DanielHeEGG/eve-flight-computer/eve-flight-computer.kicad_pcb

## KiCad design eve-flight-computer.kicad_pcb (2024-09-11)

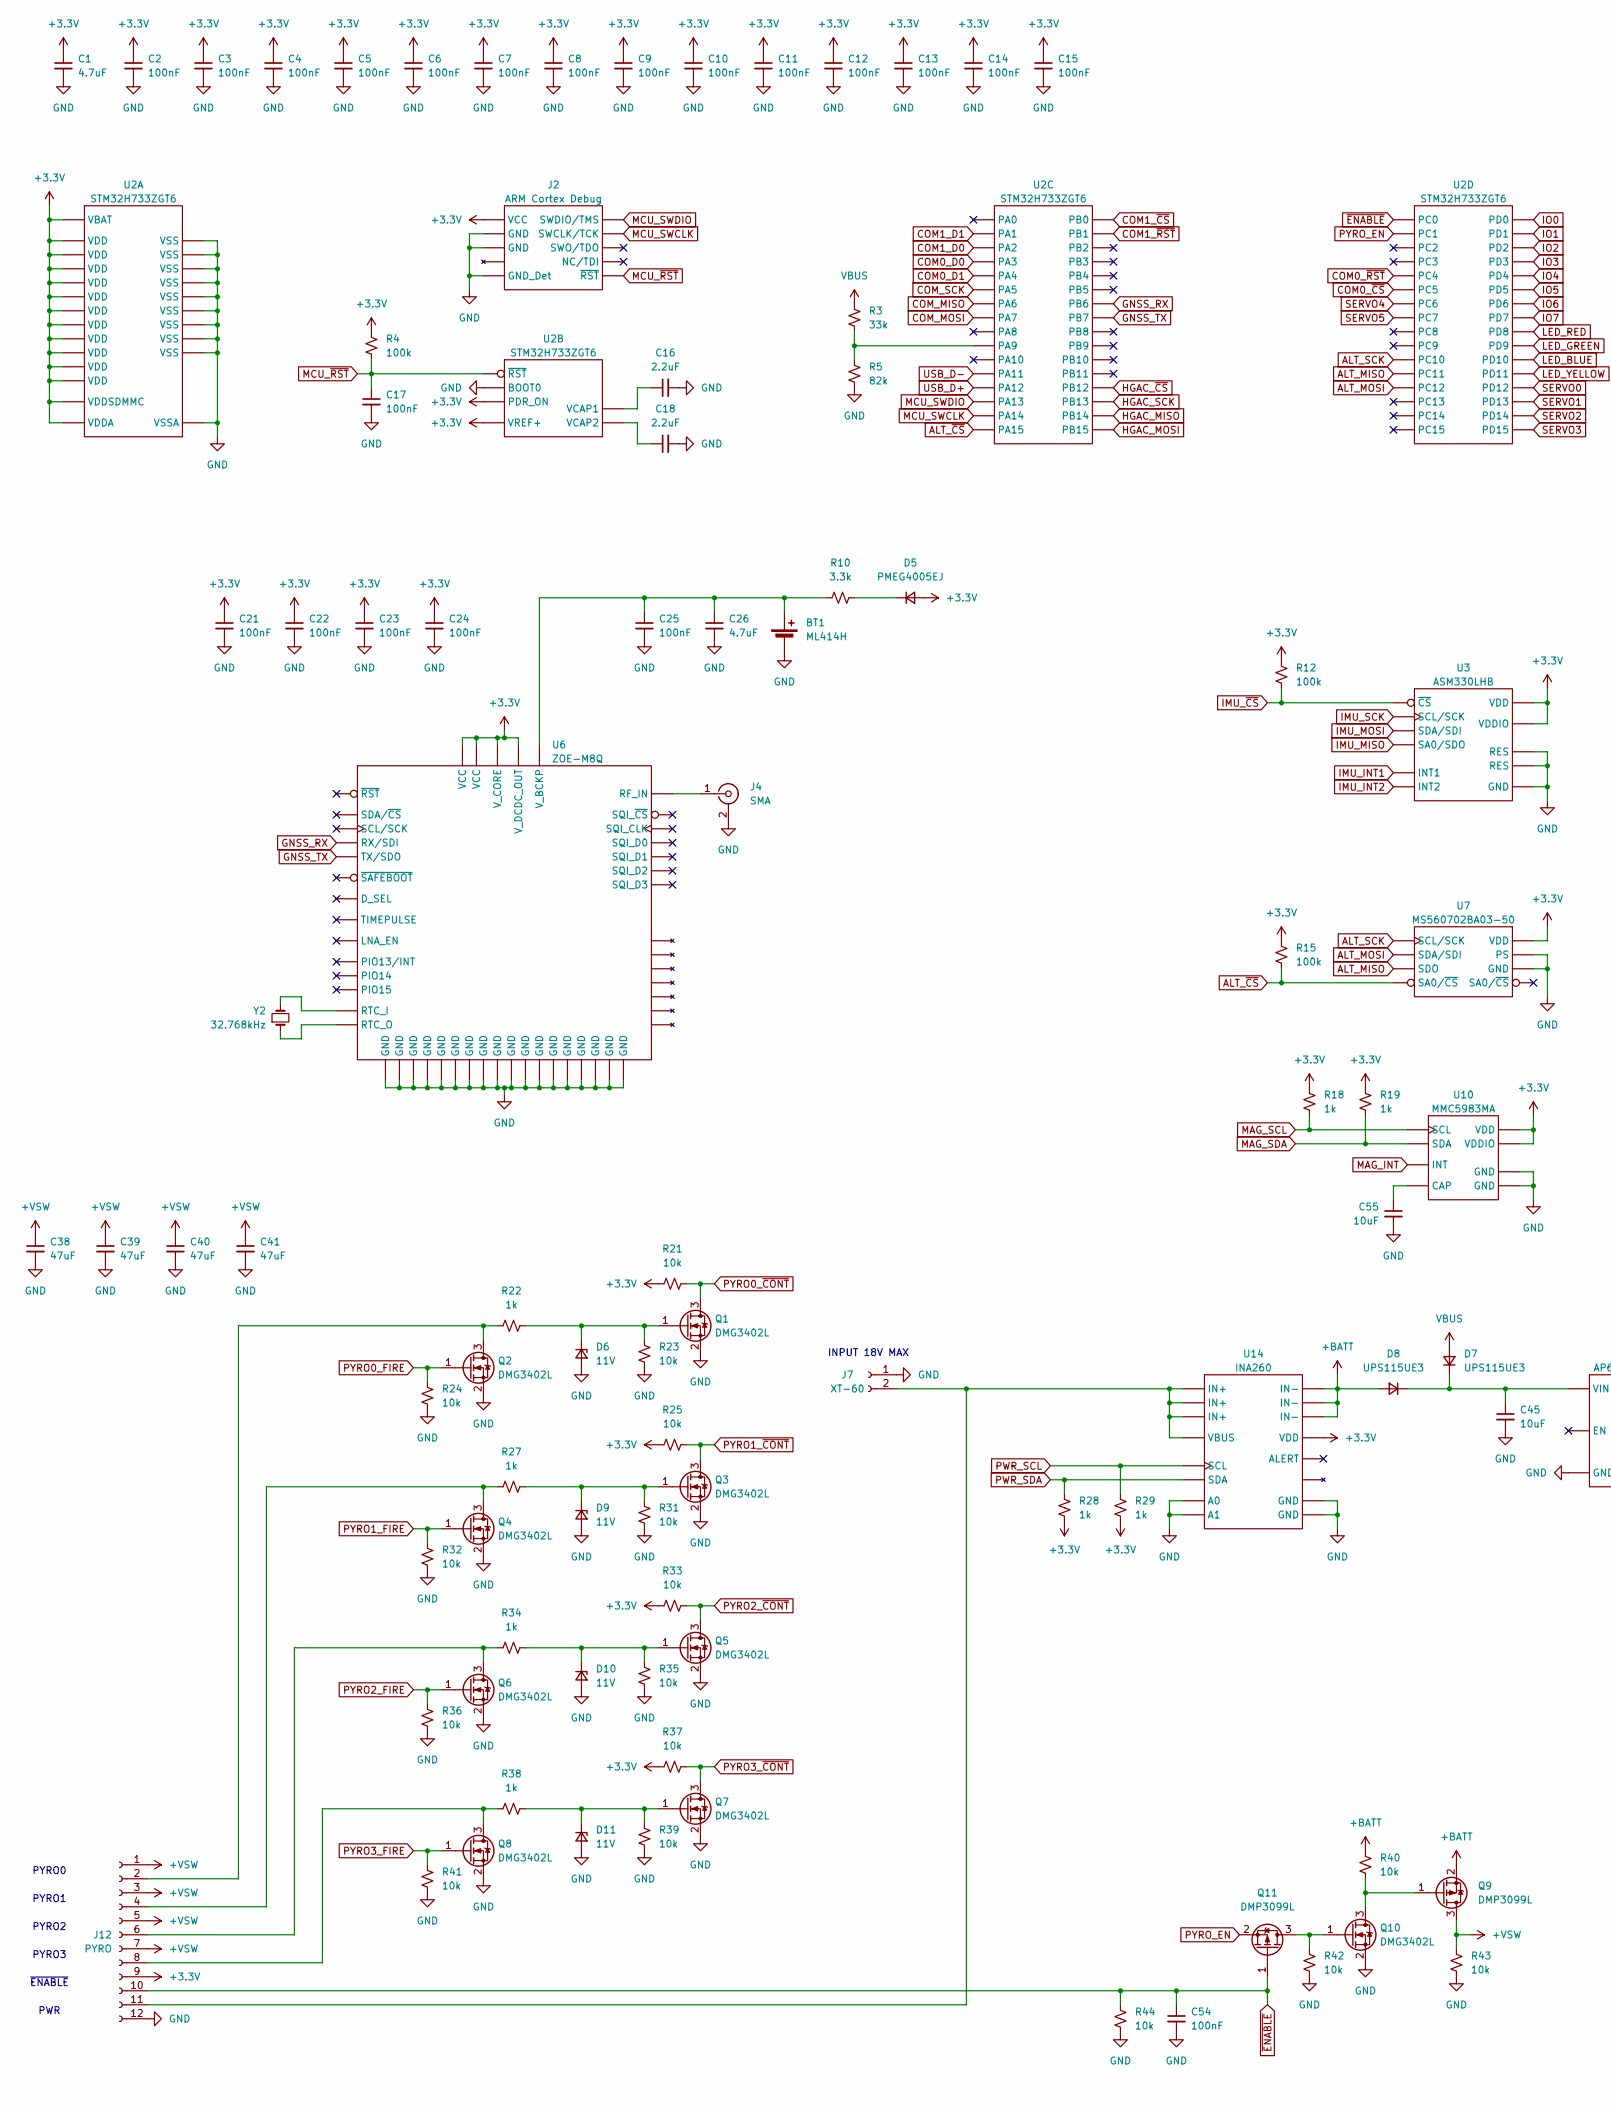
[picture p1: schematic eve-flight-computer.kicad_sch, part in row 1, column 1]

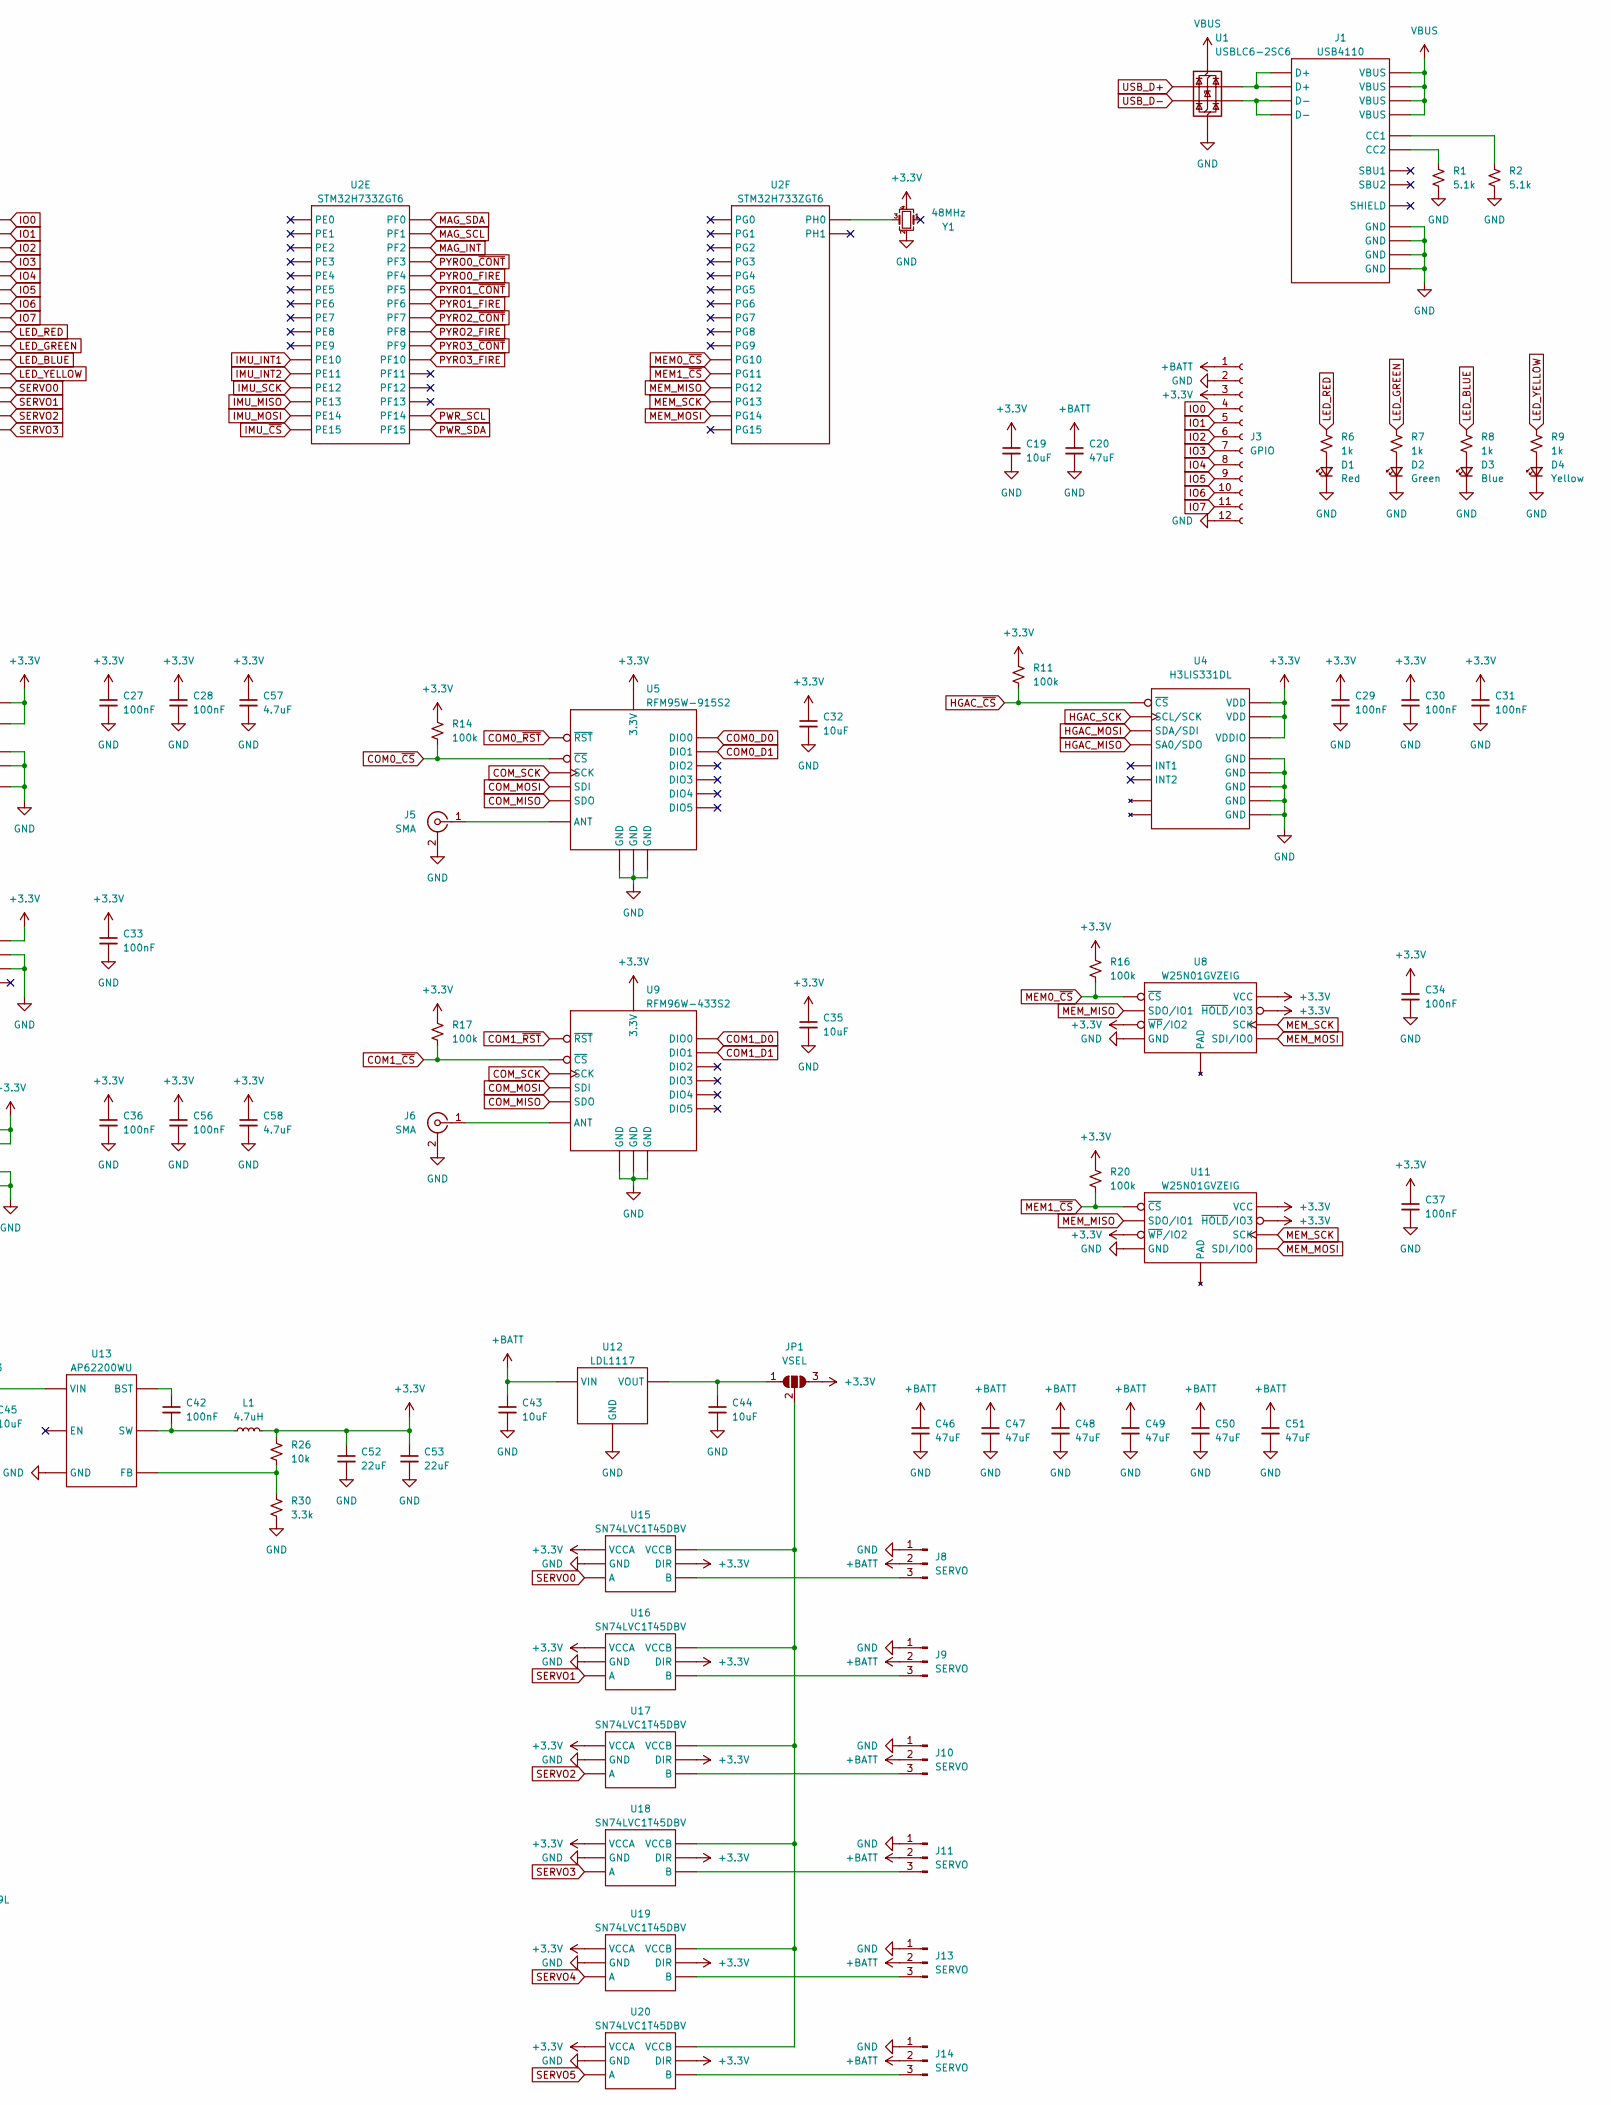
[picture p2: schematic eve-flight-computer.kicad_sch, part in row 1, column 2]

Parts:
BT1: ML414H; Part # ML414H-IV01E
C1, C26, C57, C58: 4.7uF; 0402_1005M; Part # Generic 4.7uF 6.3V X5R 0402 MLCC
C2, C3, C4, C5, C6, C7, C8, C9, C10, C11, C12, C13, C14, C15, C17, C21, C22, C23, C24, C25, C27, C28, C29, C30, C31, C33, C34, C36, C37, C42, C54, C56: 100nF; 0402_1005M; Part # Generic 100nF 25V X7R 0402 MLCC
C16, C18: 2.2uF; 0402_1005M; Part # Generic 2.2uF 6.3V X5R 0402 MLCC
C19, C32, C35, C43, C44, C45, C55: 10uF; 0805_2012M; Part # Generic 10uF 25V X5R 0805 MLCC
C20, C38, C39, C40, C41, C46, C47, C48, C49, C50, C51: 47uF; C_1206_3216Metric; Part # Generic 47uF 25V X5R 1206 MLCC
C52, C53: 22uF; 0805_2012M; Part # Generic 22uF 6.3V X5R 0805 MLCC
D1: Red; D_0603_1608Metric; Part # Generic Red 0603 LED
D2: Green; D_0603_1608Metric; Part # Generic Green 0603 LED
D3: Blue; D_0603_1608Metric; Part # Generic Blue 0603 LED
D4: Yellow; D_0603_1608Metric; Part # Generic Yellow 0603 LED
D5: PMEG4005EJ; D_SOD-323; Part # PMEG4005EJ
D6, D9, D10, D11: 11V; D_SOD-123; Part # MMSZ11T1G
D7, D8: UPS115UE3; D_Powermite_AK; Part # UPS115UE3/TR7
J1: USB4110; USB_C_Receptacle_GCT_USB4110; Part # USB4110-GF-A
J2: ARM Cortex Debug; PinHeader_2x05_P1.27mm_Vertical_SMD; Part # 20021121-00010C4LF
J3: GPIO; PinSocket_1x12_P2.54mm_Vertical; Part # 1-282834-2
J4, J5, J6: SMA; SMA_Amphenol_132289_EdgeMount; Part # 132289
J7: XT-60; XT60PW-M; Part # XT60PW-M
J8, J9, J10, J11, J13, J14: SERVO; JST_XH_B3B-XH-A_1x03_P2.50mm_Vertical; Part # B3B-XH-A
J12: PYRO; PinSocket_1x12_P2.54mm_Vertical; Part # 1-282834-2
JP1: VSEL; SolderJumper-3_P1.3mm_Open_Pad1.0x1.5mm
L1: 4.7uH; L_1210_3225Metric; Part # DFE322520FD-4R7M
Q1, Q2, Q3, Q4, Q5, Q6, Q7, Q8, Q10: DMG3402L; SOT-23-3; Part # DMG3402L-7
Q9, Q11: DMP3099L; SOT-23-3; Part # DMP3099L-7
R1, R2: 5.1k; 0402_1005M; Part # Generic 5.1k 1% 0402 Chip Resistor
R3: 33k; 0402_1005M; Part # Generic 33k 1% 0402 Chip Resistor
R4, R11, R12, R14, R15, R16, R17, R20: 100k; 0402_1005M; Part # Generic 100k 1% 0402 Chip Resistor
R5: 82k; 0402_1005M; Part # Generic 82k 1% 0402 Chip Resistor
R6, R7, R8, R9, R18, R19, R22, R27, R28, R29, R34, R38: 1k; 0402_1005M; Part # Generic 1k 1% 0402 Chip Resistor
R10, R30: 3.3k; 0402_1005M; Part # Generic 3.3k 1% 0402 Chip Resistor
R21, R23, R24, R25, R26, R31, R32, R33, R35, R36, R37, R39, R40, R41, R42, R43, R44: 10k; 0402_1005M; Part # Generic 10k 1% 0402 Chip Resistor
U1: USBLC6-2SC6; SOT-23-6; Part # USBLC6-2SC6
U2: STM32H733ZGT6; LQFP-144_20x20mm_P0.5mm; Part # STM32H733ZGT6
U3: ASM330LHB; LGA-14_3x2.5mm_P0.5mm_LayoutBorder3x4y; Part # ASM330LHBTR
U4: H3LIS331DL; LGA-16_3x3mm_P0.5mm_LayoutBorder3x5y; Part # H3LIS331DLTR
U5: RFM95W-915S2; RFM9xW-xxxS2; Part # RFM95W-915S2
U6: ZOE-M8Q; Part # ZOE-M8Q-0
U7: MS560702BA03-50; MS5607-02BA; Part # MS560702BA03-50
U8, U11: W25N01GVZEIG; WSON-8-1EP_8x6mm_P1.27mm_EP3.4x4.3mm; Part # W25N01GVZEIG
U9: RFM96W-433S2; RFM9xW-xxxS2; Part # RFM96W-433S2
U10: MMC5983MA; LGA-16_3x3mm_P0.5mm; Part # MMC5983MA
U12: LDL1117; SOT-223-3_TabPin2; Part # LDL1117S50R
U13: AP62200WU; SOT-23-6; Part # AP62200WU-7
U14: INA260; TSSOP-16_4.4x5mm_P0.65mm; Part # INA260AIPWR
U15, U16, U17, U18, U19, U20: SN74LVC1T45DBV; SOT-23-6; Part # SN74LVC1T45DBV
Y1: 48MHz; Crystal_SMD_2520-4Pin_2.5x2.0mm; Part # ECS-2520MV-480-CN-TR
Y2: 32.768kHz; Crystal_SMD_MicroCrystal_CM9V-T1A-2Pin_1.6x1.0mm; Part # CM9V-T1A-32.768KHZ-7PF-100PPM-TA-QC

Connections:
+3.3V: C1.1, C2.1, C3.1, C4.1, C5.1, C6.1, C7.1, C8.1, C9.1, C10.1, C11.1, C12.1, C13.1, C14.1, C15.1, C19.1, C21.1, C22.1, C23.1, C24.1, C27.1, C28.1, C29.1, C30.1, C31.1, C32.1, C33.1, C34.1, C35.1, C36.1, C37.1, C52.1, C53.1, C56.1, C57.1, C58.1, D5.2 (A), J2.1 (VCC), J3.3, J12.9, JP1.3 (B), L1.2, R4.1, R11.1, R12.1, R14.1, R15.1, R16.1, R17.1, R18.1, R19.1, R20.1, R21.1, R25.1, R26.1, R28.2, R29.2, R33.1, R37.1, U2.6 (VBAT), U2.17 (VDD), U2.30 (VDD), U2.32 (VREF+), U2.33 (VDDA), U2.39 (VDD), U2.52 (VDD), U2.62 (VDD), U2.72 (VDD), U2.84 (VDD), U2.95 (VDD), U2.108 (VDD), U2.121 (VDDSDMMC), U2.131 (VDD), U2.143 (PDR_ON), U2.144 (VDD), U3.5 (VDDIO), U3.8 (VDD), U4.1 (VDDIO), U4.14 (VDD), U4.15 (VDD), U5.13 (3.3V), U6.G1 (V_CORE), U6.H1 (V_DCDC_OUT), U6.J1 (VCC), U6.J2 (VCC), U7.1 (VDD), U8.3 (~WP/IO2), U8.7 (~HOLD/IO3), U8.8 (VCC), U9.13 (3.3V), U10.2 (VDD), U10.13 (VDDIO), U11.3 (~WP/IO2), U11.7 (~HOLD/IO3), U11.8 (VCC), U14.10 (VDD), U15.1 (VCCA), U15.5 (DIR), U16.1 (VCCA), U16.5 (DIR), U17.1 (VCCA), U17.5 (DIR), U18.1 (VCCA), U18.5 (DIR), U19.1 (VCCA), U19.5 (DIR), U20.1 (VCCA), U20.5 (DIR), Y1.4
+BATT: C20.1, C43.1, C46.1, C47.1, C48.1, C49.1, C50.1, C51.1, D8.2 (A), J3.1, J8.2, J9.2, J10.2, J11.2, J13.2, J14.2, Q9.2 (S), R40.1, U12.3 (VIN), U14.14 (IN-), U14.15 (IN-), U14.16 (IN-)
+VSW: C38.1, C39.1, C40.1, C41.1, J12.1, J12.3, J12.5, J12.7, Q9.3 (D), R43.1
ALT_MISO: U2.112 (PC11), U7.6 (SDO)
ALT_MOSI: U2.113 (PC12), U7.7 (SDA/SDI)
ALT_SCK: U2.111 (PC10), U7.8 (SCL/SCK)
ALT_~CS: R15.2, U2.110 (PA15), U7.5 (SA0/~CS)
COM0_D0: U2.37 (PA3), U5.14 (DIO0)
COM0_D1: U2.40 (PA4), U5.15 (DIO1)
COM0_~CS: R14.2, U2.45 (PC5), U5.5 (~CS)
COM0_~RST: U2.44 (PC4), U5.6 (~RST)
COM1_D0: U2.36 (PA2), U9.14 (DIO0)
COM1_D1: U2.35 (PA1), U9.15 (DIO1)
COM1_~CS: R17.2, U2.46 (PB0), U9.5 (~CS)
COM1_~RST: U2.47 (PB1), U9.6 (~RST)
COM_MISO: U2.42 (PA6), U5.2 (SDO), U9.2 (SDO)
COM_MOSI: U2.43 (PA7), U5.3 (SDI), U9.3 (SDI)
COM_SCK: U2.41 (PA5), U5.4 (SCK), U9.4 (SCK)
GND: BT1.2 (-), C1.2, C2.2, C3.2, C4.2, C5.2, C6.2, C7.2, C8.2, C9.2, C10.2, C11.2, C12.2, C13.2, C14.2, C15.2, C16.2, C17.2, C18.2, C19.2, C20.2, C21.2, C22.2, C23.2, C24.2, C25.2, C26.2, C27.2, C28.2, C29.2, C30.2, C31.2, C32.2, C33.2, C34.2, C35.2, C36.2, C37.2, C38.2, C39.2, C40.2, C41.2, C43.2, C44.2, C45.2, C46.2, C47.2, C48.2, C49.2, C50.2, C51.2, C52.2, C53.2, C54.2, C55.2, C56.2, C57.2, C58.2, D1.1 (K), D2.1 (K), D3.1 (K), D4.1 (K), D6.2 (A), D9.2 (A), D10.2 (A), D11.2 (A), J1.A1 (GND), J1.A12 (GND), J1.B1 (GND), J1.B12 (GND), J2.3 (GND), J2.5 (GND), J2.9 (GND_Det), J3.2, J3.12, J4.2 (Ext), J5.2 (Ext), J6.2 (Ext), J7.1, J8.1, J9.1, J10.1, J11.1, J12.12, J13.1, J14.1, Q1.2 (S), Q2.2 (S), Q3.2 (S), Q4.2 (S), Q5.2 (S), Q6.2 (S), Q7.2 (S), Q8.2 (S), Q10.2 (S), R1.2, R2.2, R5.2, R23.2, R24.2, R30.2, R31.2, R32.2, R35.2, R36.2, R39.2, R41.2, R42.2, R43.2, R44.2, U1.2, U2.16 (VSS), U2.31 (VSSA), U2.38 (VSS), U2.51 (VSS), U2.61 (VSS), U2.83 (VSS), U2.94 (VSS), U2.107 (VSS), U2.120 (VSS), U2.130 (VSS), U2.138 (BOOT0), U3.2 (RES), U3.3 (RES), U3.7 (GND), U4.5 (GND), U4.10 (GND), U4.12 (GND), U4.13 (GND), U4.16 (GND), U5.1 (GND), U5.8 (GND), U5.10 (GND), U6.A1 (GND), U6.A3 (GND), U6.A5 (GND), U6.A7 (GND), U6.A8 (GND), U6.A9 (GND), U6.B9 (GND), U6.C7 (GND), U6.C9 (GND), U6.D6 (GND), U6.D9 (GND), U6.E7 (GND), U6.F7 (GND), U6.G3 (GND), U6.G6 (GND), U6.G7 (GND), U6.J3 (GND), U6.J9 (GND), U7.2 (PS), U7.3 (GND), U8.4 (GND), U9.1 (GND), U9.8 (GND), U9.10 (GND), U10.9 (GND), U10.11 (GND), U11.4 (GND), U12.1 (GND), U13.1 (GND), U14.4 (A1), U14.5 (A0), U14.6 (GND), U14.11 (GND), U15.2 (GND), U16.2 (GND), U17.2 (GND), U18.2 (GND), U19.2 (GND), U20.2 (GND), Y1.2
GNSS_RX: U2.136 (PB6), U6.J4 (RX/SDI)
GNSS_TX: U2.137 (PB7), U6.J5 (TX/SDO)
HGAC_MISO: U2.75 (PB14), U4.7 (SA0/SDO)
HGAC_MOSI: U2.76 (PB15), U4.6 (SDA/SDI)
HGAC_SCK: U2.74 (PB13), U4.4 (SCL/SCK)
HGAC_~CS: R11.2, U2.73 (PB12), U4.8 (~CS)
IMU_INT1: U2.63 (PE10), U3.4 (INT1)
IMU_INT2: U2.64 (PE11), U3.9 (INT2)
IMU_MISO: U2.66 (PE13), U3.1 (SA0/SDO)
IMU_MOSI: U2.67 (PE14), U3.14 (SDA/SDI)
IMU_SCK: U2.65 (PE12), U3.13 (SCL/SCK)
IMU_~CS: R12.2, U2.68 (PE15), U3.12 (~CS)
IO0: J3.4, U2.114 (PD0)
IO1: J3.5, U2.115 (PD1)
IO2: J3.6, U2.116 (PD2)
IO3: J3.7, U2.117 (PD3)
IO4: J3.8, U2.118 (PD4)
IO5: J3.9, U2.119 (PD5)
IO6: J3.10, U2.122 (PD6)
IO7: J3.11, U2.123 (PD7)
LED_BLUE: R8.1, U2.79 (PD10)
LED_GREEN: R7.1, U2.78 (PD9)
LED_RED: R6.1, U2.77 (PD8)
LED_YELLOW: R9.1, U2.80 (PD11)
MAG_INT: U2.12 (PF2), U10.15 (INT)
MAG_SCL: R18.2, U2.11 (PF1), U10.1 (SCL)
MAG_SDA: R19.2, U2.10 (PF0), U10.16 (SDA)
MCU_SWCLK: J2.4 (SWCLK/TCK), U2.109 (PA14)
MCU_SWDIO: J2.2 (SWDIO/TMS), U2.105 (PA13)
MCU_~RST: C17.1, J2.10 (~RST), R4.2, U2.25 (~RST)
MEM0_~CS: R16.2, U2.125 (PG10), U8.1 (~CS)
MEM1_~CS: R20.2, U2.126 (PG11), U11.1 (~CS)
MEM_MISO: U2.127 (PG12), U8.2 (SDO/IO1), U11.2 (SDO/IO1)
MEM_MOSI: U2.129 (PG14), U8.5 (SDI/IO0), U11.5 (SDI/IO0)
MEM_SCK: U2.128 (PG13), U8.6 (SCK), U11.6 (SCK)
unnamed: BT1.1 (+), C25.1, C26.1, R10.1, U6.H9 (V_BCKP)
unnamed: D1.2 (A), R6.2
unnamed: D2.2 (A), R7.2
unnamed: D3.2 (A), R8.2
unnamed: D4.2 (A), R9.2
unnamed: D5.1 (K), R10.2
unnamed: D6.1 (K), Q1.1 (G), R22.2, R23.1
unnamed: C45.1, D7.1 (K), D8.1 (K), U13.3 (VIN)
unnamed: D9.1 (K), Q3.1 (G), R27.2, R31.1
unnamed: D10.1 (K), Q5.1 (G), R34.2, R35.1
unnamed: D11.1 (K), Q7.1 (G), R38.2, R39.1
unnamed: J1.A5 (CC1), R2.1
unnamed: J1.B5 (CC2), R1.1
unnamed: J1.A6 (D+), J1.B6 (D+), U1.6
unnamed: J1.A7 (D-), J1.B7 (D-), U1.4
unnamed: J4.1 (In), U6.A4 (RF_IN)
unnamed: J5.1 (In), U5.9 (ANT)
unnamed: J6.1 (In), U9.9 (ANT)
unnamed: J8.3, U15.4 (B)
unnamed: J9.3, U16.4 (B)
unnamed: J10.3, U17.4 (B)
unnamed: J11.3, U18.4 (B)
unnamed: J12.2, Q2.3 (D), R22.1
unnamed: J12.4, Q4.3 (D), R27.1
unnamed: J12.6, Q6.3 (D), R34.1
unnamed: J12.8, Q8.3 (D), R38.1
unnamed: J7.2, J12.11, U14.1 (IN+), U14.2 (IN+), U14.3 (IN+), U14.12 (VBUS)
unnamed: J13.3, U19.4 (B)
unnamed: J14.3, U20.4 (B)
unnamed: C44.1, JP1.1 (A), U12.2 (VOUT)
unnamed: JP1.2 (C), U15.6 (VCCB), U16.6 (VCCB), U17.6 (VCCB), U18.6 (VCCB), U19.6 (VCCB), U20.6 (VCCB)
unnamed: Q9.1 (G), Q10.3 (D), R40.2
unnamed: Q10.1 (G), Q11.3 (D), R42.1
unnamed: C16.1, U2.71 (VCAP1)
unnamed: C18.1, U2.106 (VCAP2)
unnamed: R3.2, R5.1, U2.101 (PA9)
unnamed: U2.23 (PH0), Y1.3
unnamed: U6.J7 (RTC_I), Y2.2
unnamed: U6.J8 (RTC_O), Y2.1
unnamed: C55.1, U10.10 (CAP)
unnamed: C42.1, U13.6 (BST)
unnamed: R26.2, R30.1, U13.4 (FB)
unnamed: C42.2, L1.1, U13.2 (SW)
PWR_SCL: R29.1, U2.54 (PF14), U14.9 (SCL)
PWR_SDA: R28.1, U2.55 (PF15), U14.8 (SDA)
PYRO0_FIRE: Q2.1 (G), R24.1, U2.14 (PF4)
PYRO0_~CONT: Q1.3 (D), R21.2, U2.13 (PF3)
PYRO1_FIRE: Q4.1 (G), R32.1, U2.18 (PF6)
PYRO1_~CONT: Q3.3 (D), R25.2, U2.15 (PF5)
PYRO2_FIRE: Q6.1 (G), R36.1, U2.20 (PF8)
PYRO2_~CONT: Q5.3 (D), R33.2, U2.19 (PF7)
PYRO3_FIRE: Q8.1 (G), R41.1, U2.22 (PF10)
PYRO3_~CONT: Q7.3 (D), R37.2, U2.21 (PF9)
PYRO_EN: Q11.2 (S), U2.27 (PC1)
SERVO0: U2.81 (PD12), U15.3 (A)
SERVO1: U2.82 (PD13), U16.3 (A)
SERVO2: U2.85 (PD14), U17.3 (A)
SERVO3: U2.86 (PD15), U18.3 (A)
SERVO4: U2.96 (PC6), U19.3 (A)
SERVO5: U2.97 (PC7), U20.3 (A)
USB_D+: U1.1, U2.104 (PA12)
USB_D-: U1.3, U2.103 (PA11)
VBUS: D7.2 (A), J1.A4 (VBUS), J1.A9 (VBUS), J1.B4 (VBUS), J1.B9 (VBUS), R3.1, U1.5
~ENABLE: C54.1, J12.10, Q11.1 (G), R44.1, U2.26 (PC0)

Notes on the sheet:
~{ENABLE}
INPUT 18V MAX
PYRO3
PWR
PYRO1
PYRO2
PYRO0

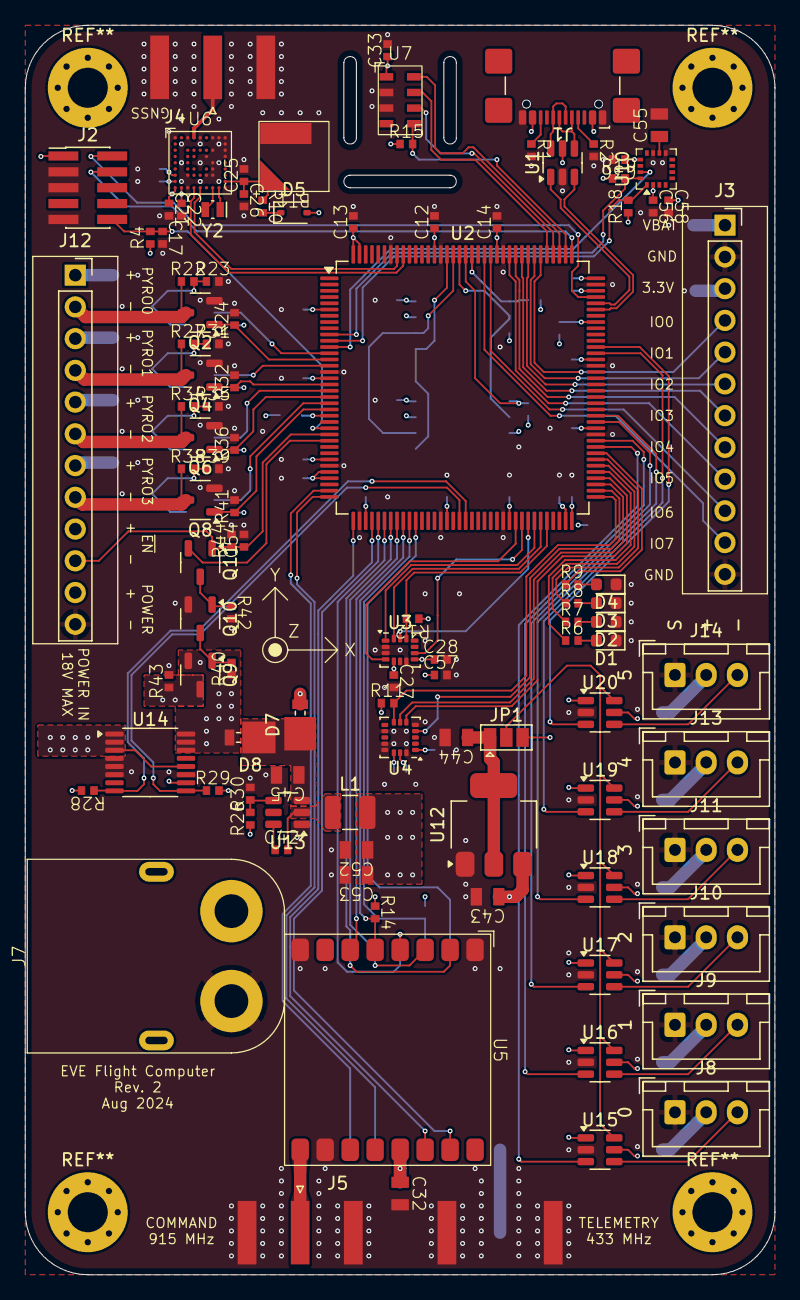
[picture p3: board eve-flight-computer.kicad_pcb from above]

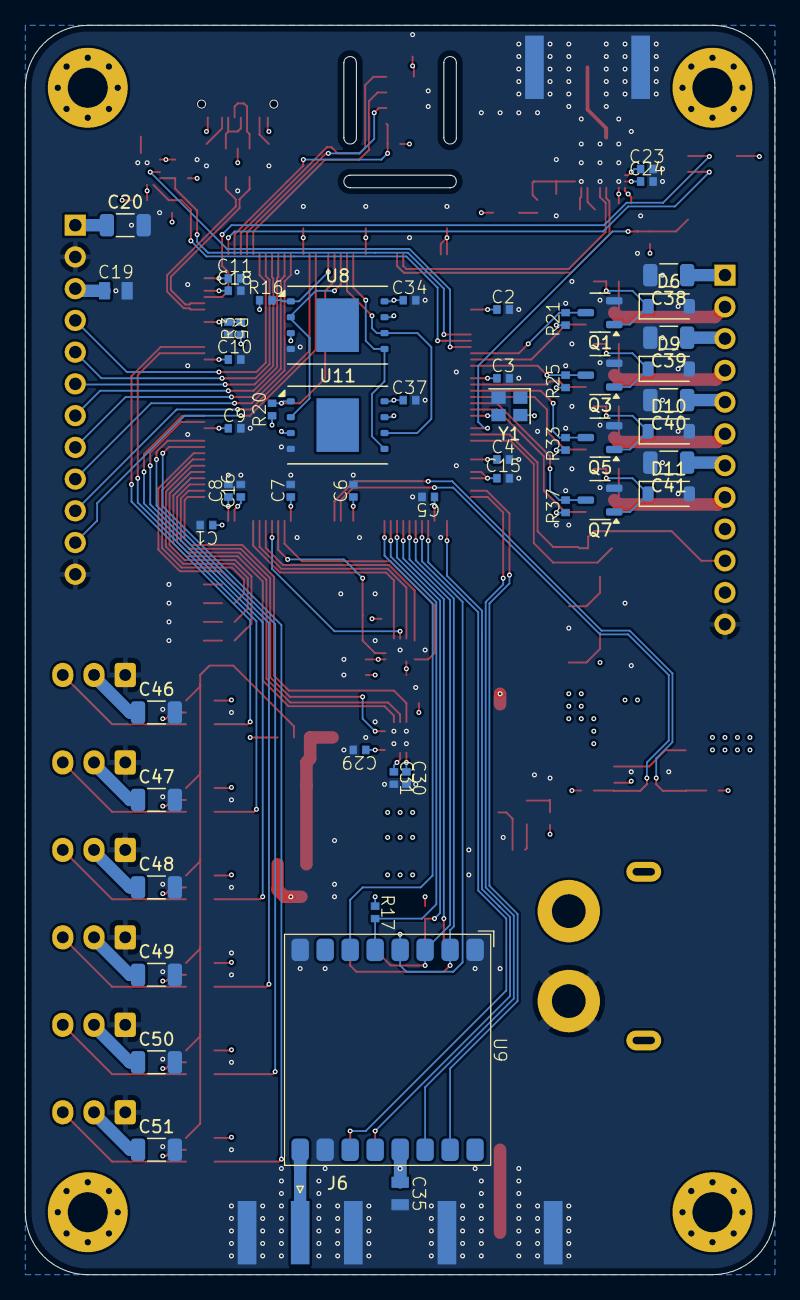
[picture p4: board eve-flight-computer.kicad_pcb from below]

Board: 6 copper layers, 60.0 x 100.0 mm, 162 parts (56 on the bottom side), 118 nets.
