DanielHeEGG/eve-flight-computer/(commit log)

2024-07-06 Design file setup, add design rules
    [eve-flight-computer.kicad_pcb, eve-flight-computer.kicad_sch]
2024-08-28 Rev. 1
    [eve-flight-computer.kicad_pcb, eve-flight-computer.kicad_sch]
2024-09-11 Rev. 2
    [eve-flight-computer.kicad_pcb, eve-flight-computer.kicad_sch]
